menkueclab/TR-Switch/TRSW v1.2 assembled.jpg

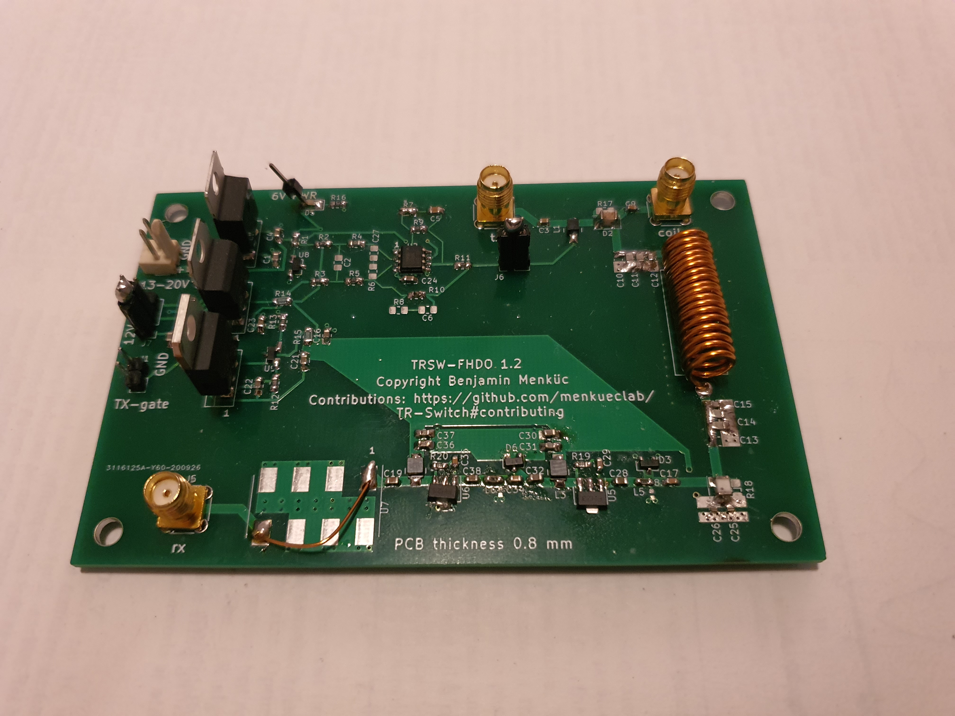
TRSW v1.2 assembled.jpg
