menkueclab/TR-Switch/measurements/orig tx to rx transition adjusted scale.jpg

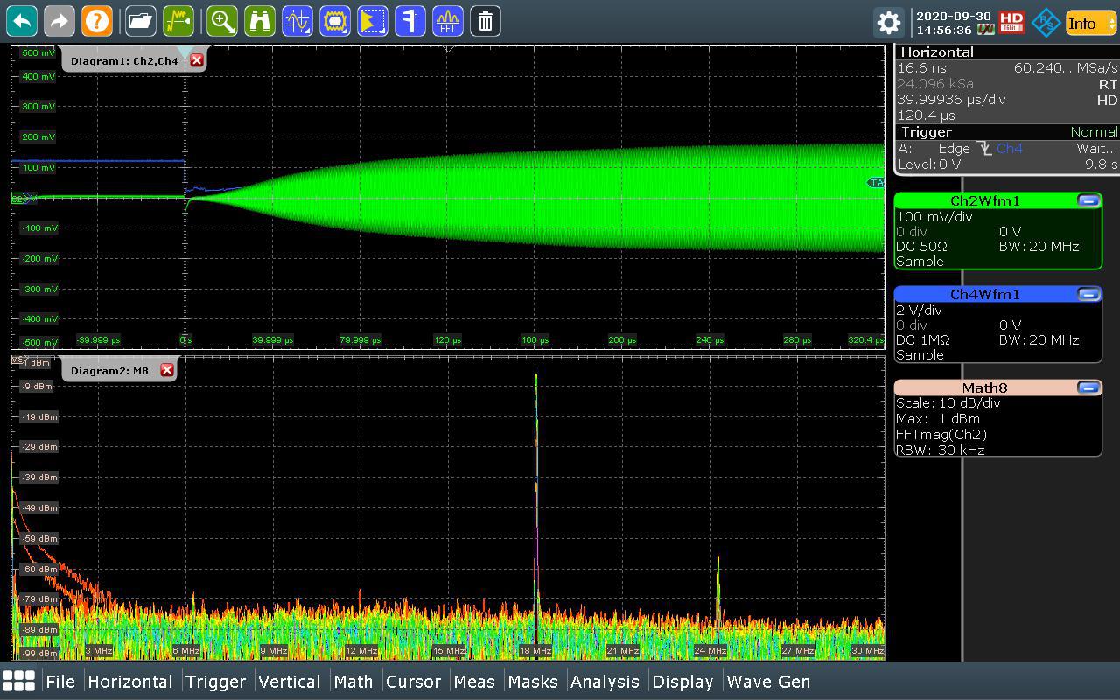
measurements/orig tx to rx transition adjusted scale.jpg
