menkueclab/TR-Switch/README.md

# TR-Switch
T/R Switch with LNA for low-field MRI.

[Read more](https://github.com/menkueclab/TR-Switch/wiki)

### Contributing

  * Jason Stockmann
  * Thomas Witzel
  * Don 
  * Lincoln Craven-Brightman
  * Marcus Prier
  * Odin Holmes

### References

  * https://tabletop.martinos.org/index.php/Hardware:RF
  * http://rflab.martinos.org/index.php/Low-noise_RF_Preamplifier
  
### Disclaimer
Not intended for medical use!
