menkueclab/TR-Switch/sim/loopgain no compensation.png

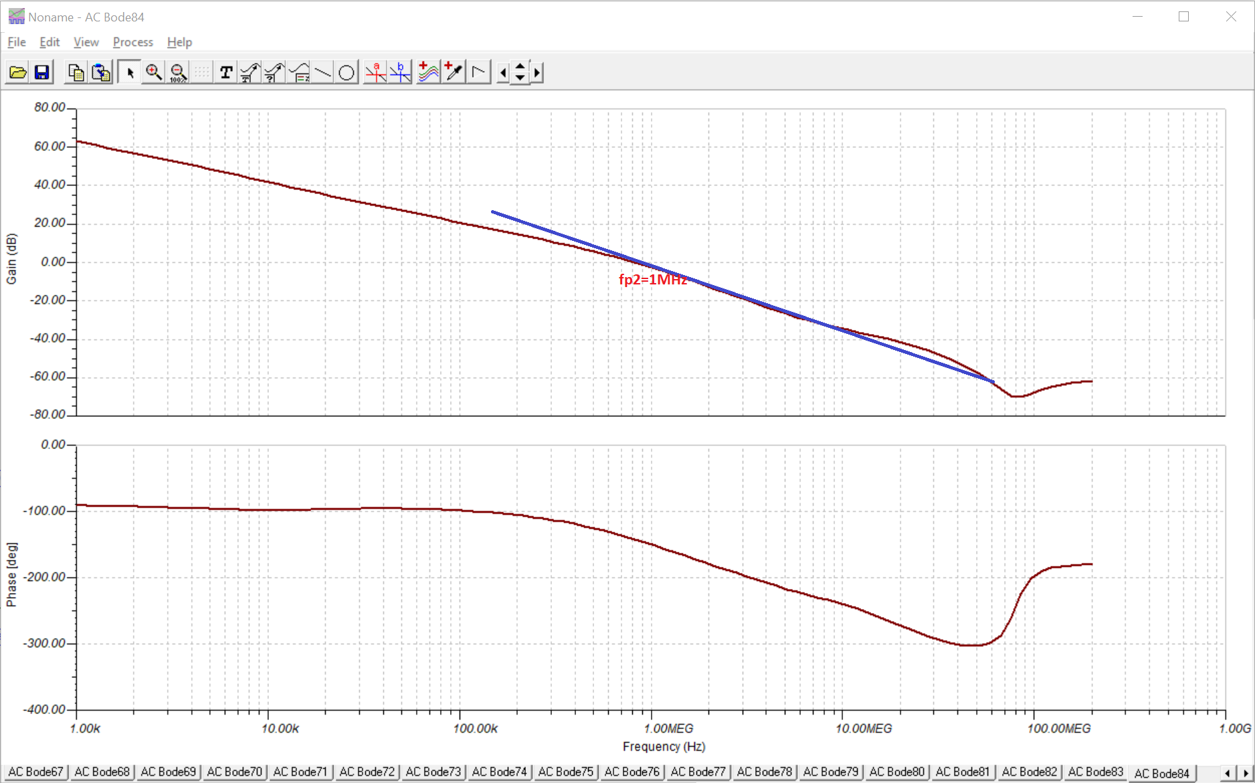
sim/loopgain no compensation.png
