menkueclab/TR-Switch/sim/loopgain with feedback lead compensation and lag compensation.png

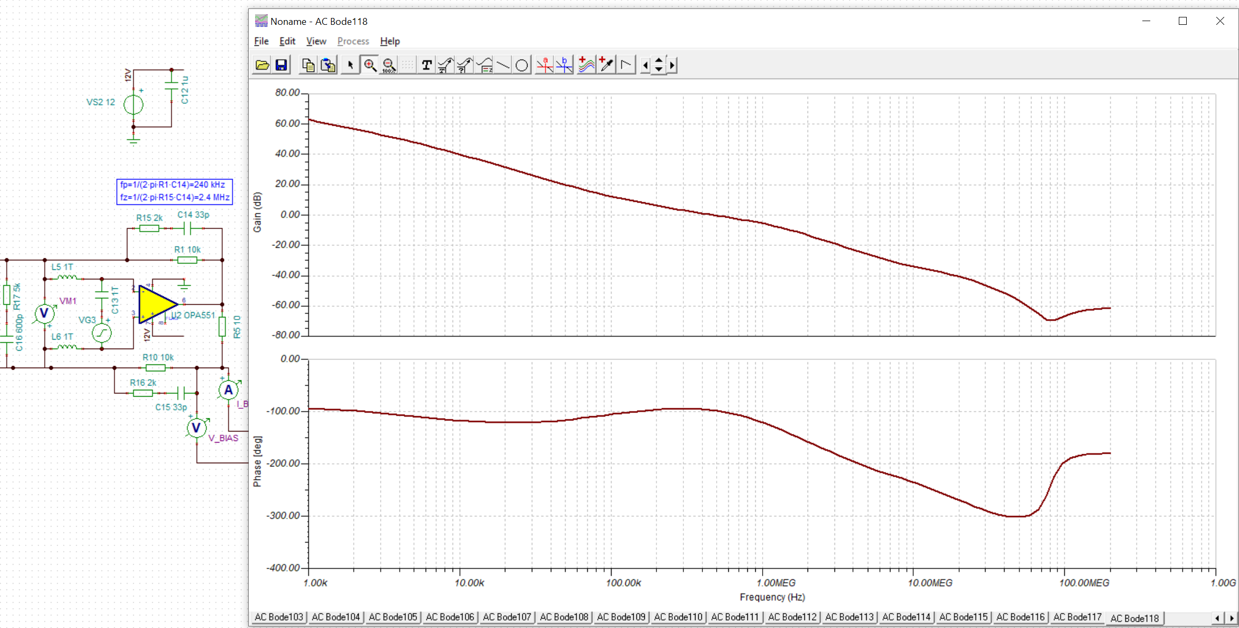
sim/loopgain with feedback lead compensation and lag compensation.png
