menkueclab/TR-Switch/sim/loopgain with feedback lead compensation.png

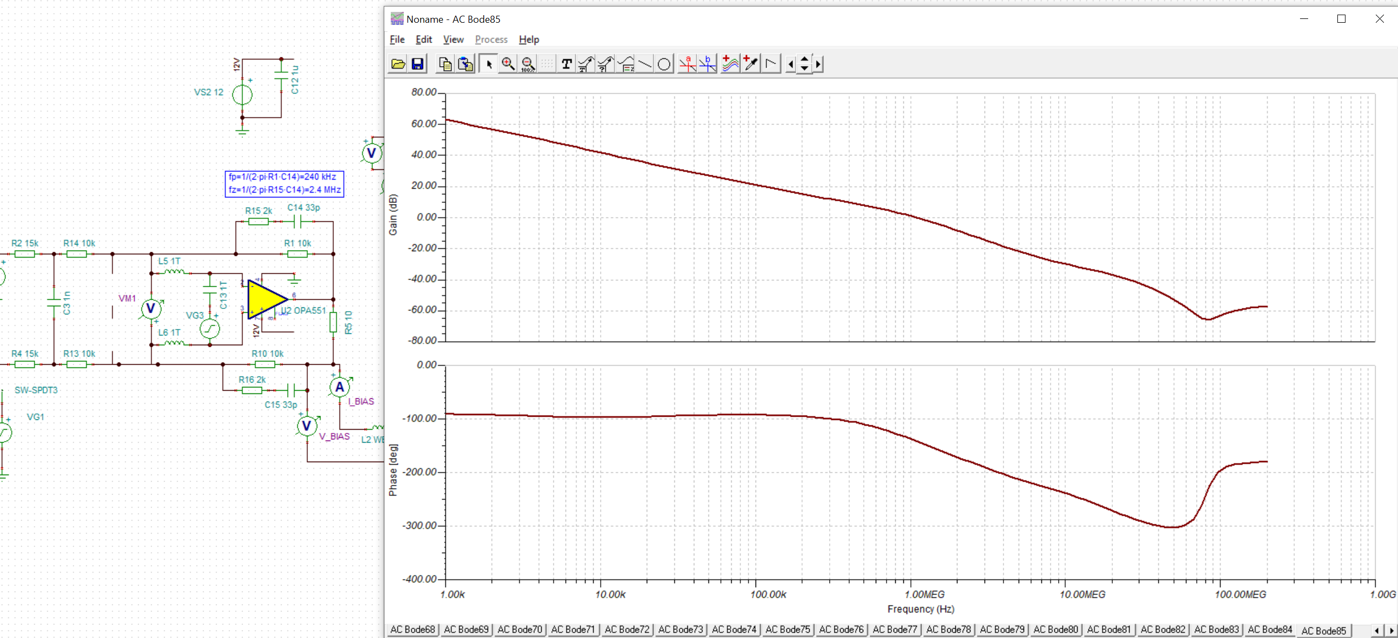
sim/loopgain with feedback lead compensation.png
