menkueclab/TR-Switch/sim/loopgain with lag compensation.png

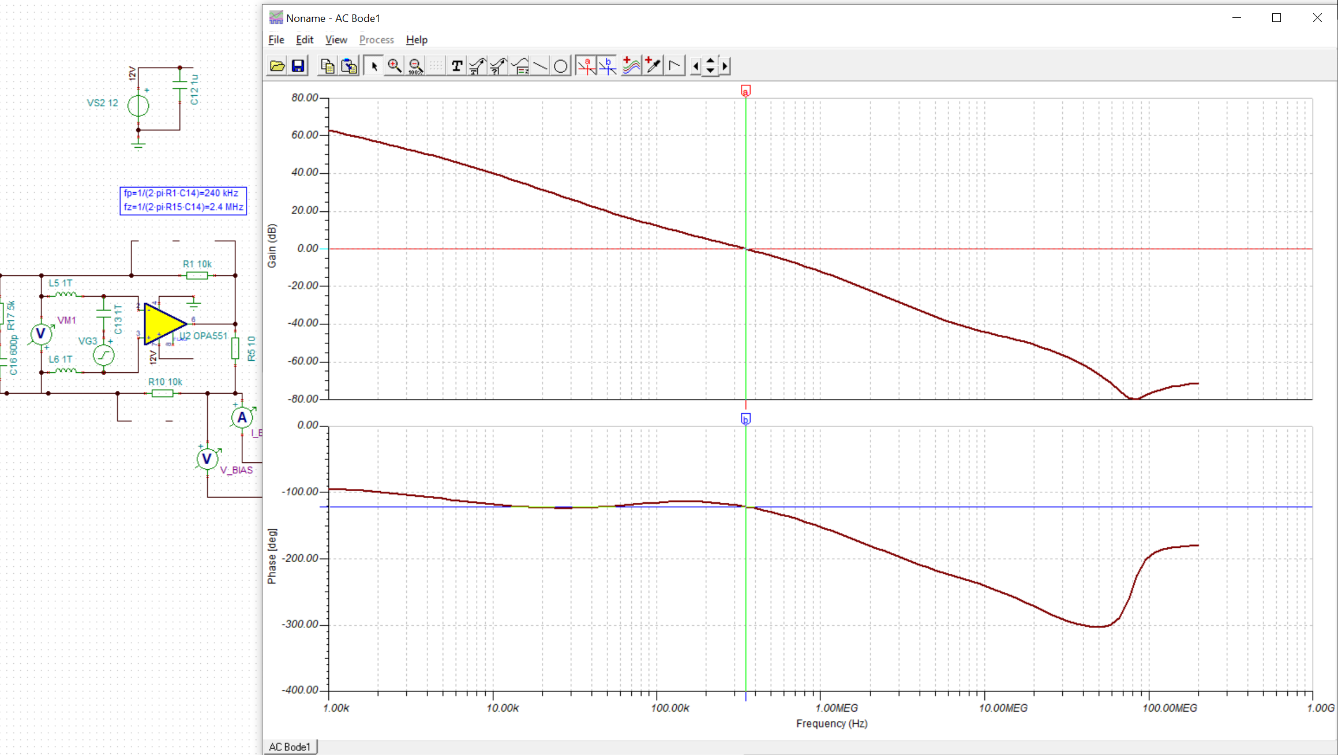
sim/loopgain with lag compensation.png
