menkueclab/TR-Switch/sim/loopgain without transmitter.png

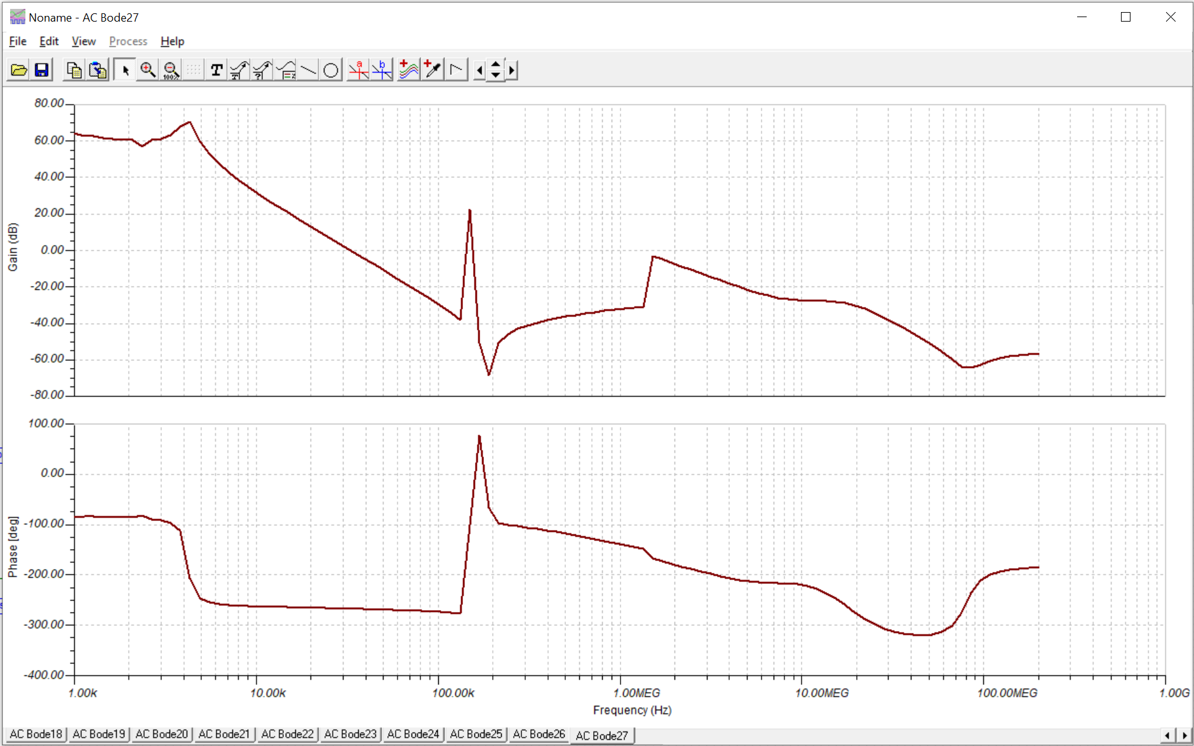
sim/loopgain without transmitter.png
