menkueclab/TR-Switch/TRSW v1.2.jpg

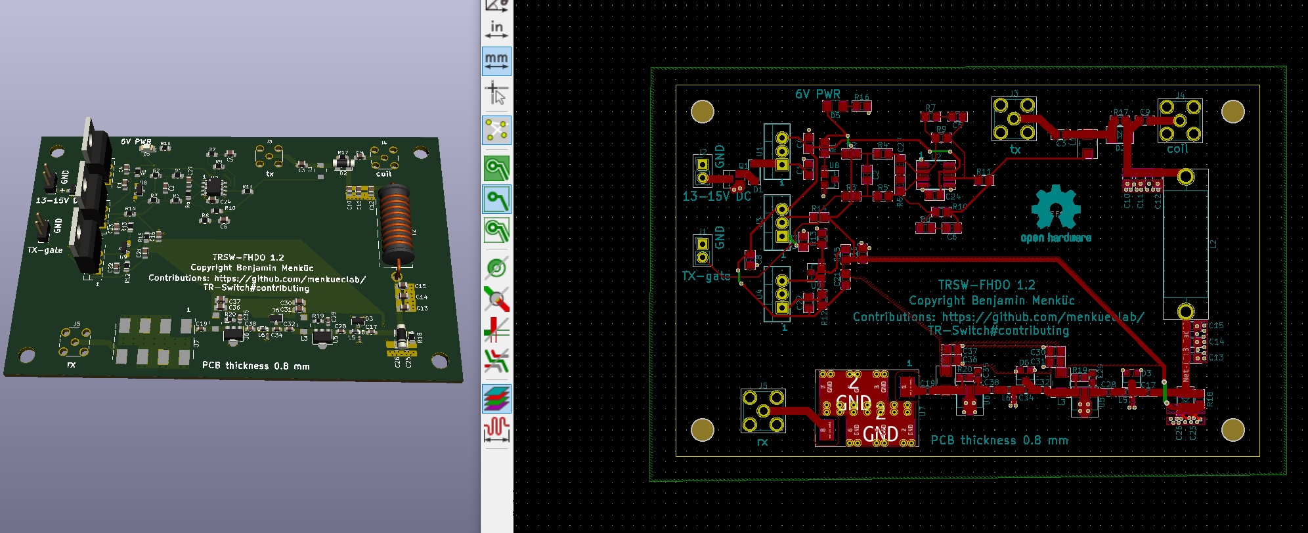
TRSW v1.2.jpg
