menkueclab/TR-Switch/parts/Warenkorb_Nov06_0358.xls

WARENKORB
Dies ist keine Rechnung
06-Nov-20 03:58:51
 | Mouser-Nr. | Herst.- Nr. | Hersteller | Kunden-Teilenr | Beschreibung | RoHS | Lebenszyklus | Stückzahl | Preis (EUR) | Gesamtpreis: (EUR)
1 | 841-BAT54GWX | BAT54GWX | Nexperia |  | Schottky Dioden & Gleichrichter DIODE SCHOTTKY | RoHS-konform |  | 1 | 0,119 € | 0,12 €
2 | 80-C0603C104J4RECLR | C0603C104J4REC7411 | KEMET |  | Kondensator aus mehreren Keramikschichten MLCC - SMD/SMT 16V 0.1uF 0603 X7R 0.05 | RoHS-konform |  | 5 | 0,161 € | 0,81 €
3 | 963-LMK107BJ225KK-T | LMK107BJ225KK-T | Taiyo Yuden |  | Kondensator aus mehreren Keramikschichten MLCC - SMD/SMT 0603 10VDC 2.2uF 10% X5R | RoHS-konform | Neues Produkt | 4 | 0,195 € | 0,78 €
4 | 605-501R15W102KV4T | 501R15W102KV4T | Johanson |  | Kondensator aus mehreren Keramikschichten MLCC - SMD/SMT 500volts 1000pF 10% X7R | RoHS-konform |  | 4 | 0,237 € | 0,95 €
5 | 963-LMK212ABJ106KGHT | LMK212ABJ106KGHT | Taiyo Yuden |  | Kondensator aus mehreren Keramikschichten MLCC - SMD/SMT 0805 10V 10uF 10% X5R AEC-Q200 | RoHS-konform |  | 6 | 0,161 € | 0,97 €
6 | 810-C0510X5R1A474MAC | C0510X5R1A474M030BC | TDK |  | Kondensator aus mehreren Keramikschichten MLCC - SMD/SMT 0204 10V 0.47uF X5R 20% T: 0.3mm | RoHS-konform |  | 2 | 0,356 € | 0,71 €
7 | 81-GRM1555C1H1R5WA1D | GRM1555C1H1R5WA01D | Murata |  | Kondensator aus mehreren Keramikschichten MLCC - SMD/SMT 1.5PF 50V .05PF 0402 | RoHS-konform | NRND | 2 | 0,102 € | 0,20 €
8 | 80-C0805X105K8RACLR | C0805X105K8RAC7210 | KEMET |  | Kondensator aus mehreren Keramikschichten MLCC - SMD/SMT 10V 1uF X7R 0805 10% Flex | RoHS-konform | Neues Produkt | 4 | 0,745 € | 2,98 €
9 | 605-501R15N470JV4T | 501R15N470JV4T | Johanson |  | Kondensator aus mehreren Keramikschichten MLCC - SMD/SMT 500volts 47pF 5% NPO | RoHS-konform |  | 4 | 0,263 € | 1,05 €
10 | 605-501R15N101JV4T | 501R15N101JV4T | Johanson |  | Kondensator aus mehreren Keramikschichten MLCC - SMD/SMT 500volts 100pF 5% NPO | RoHS-konform |  | 2 | 0,237 € | 0,47 €
11 | 80-C0603X104K5R3316 | C0603X104K5RAC3316 | KEMET |  | Kondensator aus mehreren Keramikschichten MLCC - SMD/SMT 50V .1uF X7R AUTO 5mm Flex VW80808 | RoHS-konform | Neues Produkt | 1 | 0,161 € | 0,16 €
12 | 667-ERA-3VEB1501V | ERA-3VEB1501V | Panasonic |  | Dünnfilmwiderstände - SMD 0603 0.1% 1.5Kohm 25ppm SMD | RoHS-konform | Neues Produkt | 2 | 0,449 € | 0,90 €
13 | 667-ERJ-6RED1004V | ERJ-6RED1004V | Panasonic |  | Dickfilmwiderstände - SMD 0805 Resistor 0.5% 100ppm 1MOhm |  |  | 2 | 0,178 € | 0,36 €
14 | 667-ERJ-U06F1R00V | ERJ-U06F1R00V | Panasonic |  | Dickfilmwiderstände - SMD 0805 1% 1ohm AEC-Q200 Anti-Sulfur | RoHS: Konform durch Ausnahmegenehmigung | Neues Produkt | 2 | 0,161 € | 0,32 €
15 | 652-CMP0805AFX-10R0L | CMP0805AFX-10R0ELF | Bourns |  | Dickfilmwiderstände - SMD 10 OHM 1% 1/2W TC100 | RoHS-konform | Neues Produkt | 1 | 0,102 € | 0,10 €
16 | 652-CMP0805-FX-1000L | CMP0805-FX-1000ELF | Bourns |  | Dickfilmwiderstände - SMD 100 OHM 1% 1/2W TC100 | RoHS-konform | Neues Produkt | 3 | 0,085 € | 0,26 €
17 | 652-CMP0805AFX-1002L | CMP0805AFX-1002ELF | Bourns |  | Dickfilmwiderstände - SMD 10K OHM 1% 1/2W TC100 | RoHS-konform | Neues Produkt | 4 | 0,102 € | 0,41 €
18 | 71-RCC080515K0FKEA | RCC080515K0FKEA | Vishay |  | Dickfilmwiderstände - SMD 1/4W 15Kohms 1% 100ppm | RoHS: Konform durch Ausnahmegenehmigung | Neues Produkt | 2 | 0,152 € | 0,30 €
19 | 771-PMV100EPAR | PMV100EPAR | Nexperia |  | MOSFET PMV100EPAR | RoHS-konform | Neues Produkt | 1 | 0,347 € | 0,35 €
20 | 994-0603CS-5N1XJLU | 0603CS-5N1XJLU | Coilcraft |  | Festinduktivitäten 0603 5.1nH Unshld 5% 700mA 140mOhms AECQ2 | RoHS-konform |  | 2 | 0,766 € | 1,53 €
21 | 583-BAV99 | BAV99 | Rectron |  | Dioden (Allzweck, Leistung, Schaltung) SOT23,215mA,75V,Dual,Switching | RoHS-konform |  | 2 | 0,108 € | 0,22 €
22 | 522-LM4040C25FTA | LM4040C25FTA | Diodes Incorporated |  | Spannungsreferenzen 0.5% 2.5V Reference | RoHS-konform |  | 2 | 0,542 € | 1,08 €
23 | 937-MA4P7001F-1072-T | MA4P7001F-1072T | MACOM |  | Pin-Dioden .1-1500MHz .7pF Min Vr 100Vdc |  |  | 2 | 6,01 € | 12,02 €
24 | 81-LQH32DN150K53L | LQH32DN150K53L | Murata |  | Festinduktivitäten 1210 15uH 10% 300mA 0.65ohms 26MHz(SRF) | RoHS-konform |  | 2 | 0,28 € | 0,56 €
25 | 710-744766902 | 744766902 | Wurth Elektronik |  | Festinduktivitäten WE-GFH HiFreq 4532 2.2uH 1450mA 16mOhms | RoHS-konform |  | 1 | 0,33 € | 0,33 €
26 | 424-6-PIN-HEADER | 240-004 | Digilent |  | Sockel & Kabelgehäuse 6-pin Header & Gender Changer (5-pack) | RoHS-konform |  | 4 | 1,26 € | 5,04 €
27 | 523-901-144-8RFX | 901-144-8RFX | Amphenol |  | RF-Steckverbinder/Koaxial-Steckverbinder VERTICAL PCB JACK GOLD PLATED BRASS | RoHS: Konform durch Ausnahmegenehmigung |  | 3 | 4,05 € | 12,15 €
28 | 926-LM337T/NOPB | LM337T/NOPB | Texas Instruments |  | Lineare Spannungsregler 3-TERMINAL ADJ NEG REG | RoHS: Konform durch Ausnahmegenehmigung |  | 1 | 1,47 € | 1,47 €
29 | 511-LM317T | LM317T | STMicroelectronics |  | Lineare Spannungsregler 1.2-37V Adj Positive 1.5 Amp Output | RoHS-konform |  | 1 | 0,542 € | 0,54 €
30 | 595-OPA551UA/2K5 | OPA551UA/2K5 | Texas Instruments |  | Operationsverstärker High-Volt High-Crnt Oper Amplifier | RoHS-konform |  | 1 | 3,76 € | 3,76 €
31 | 511-L7812ABV-DG | L7812ABV-DG | STMicroelectronics |  | Lineare Spannungsregler 1.5A POS REG IC 12V Output Voltage | RoHS-konform |  | 1 | 0,525 € | 0,53 €
32 | 327-BR1101WTR | BR1101W-TR | Stanley Electric |  | Standard-LEDs - SMD Surface Mount LED | RoHS-konform | Neu bei Mouser | 1 | 0,347 € | 0,35 €
33 | 994-143-11J12SL | 143-11J12SL | Coilcraft |  | Variable Induktivitäten 143 Unicoil Tunable 19.2 mOhms 6.8 A | RoHS-konform |  | 1 | 2,49 € | 2,49 €
34 | 984-ATS-PCB1001 | ATS-PCB1001 | Advanced Thermal Solutions |  | Wärmeableitungen BGA Heatsink, High Performance, Board Level Stamped, No TIM, Black-Anodized, TO-220, 19x12.8x12.7mm (LxWxH) | RoHS-konform | Neues Produkt | 3 | 0,491 € | 1,47 €
Durch das Absenden Ihrer Bestellung erklären Sie sich mit diesen Geschäftsbedingungen einverstanden. (https://eu.mouser.com/saleterms) |  |  |  |  |  |  |  |  | Gesamtwarenkosten: | 55,74 €
Die Preise sind zum angezeigten Datum und zur Uhrzeit reflektiert. |  |  |  |  |  |  |  |  | Versandkosten: | 0,00 €
 |  |  |  |  |  |  |  |  | Versand von Nachlieferungen: | Schätzung
