menkueclab/TR-Switch/measurements/orig tx to rx transition.jpg

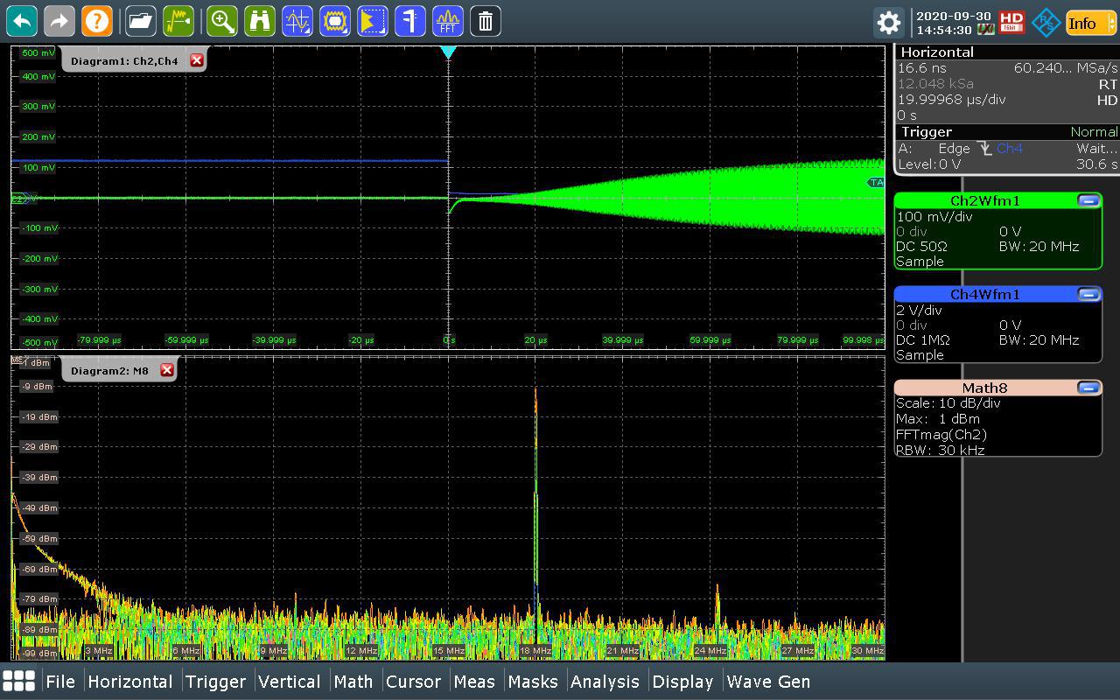
measurements/orig tx to rx transition.jpg
