menkueclab/TR-Switch/measurements/v1.1 S21 coil-rx rx-mode.png

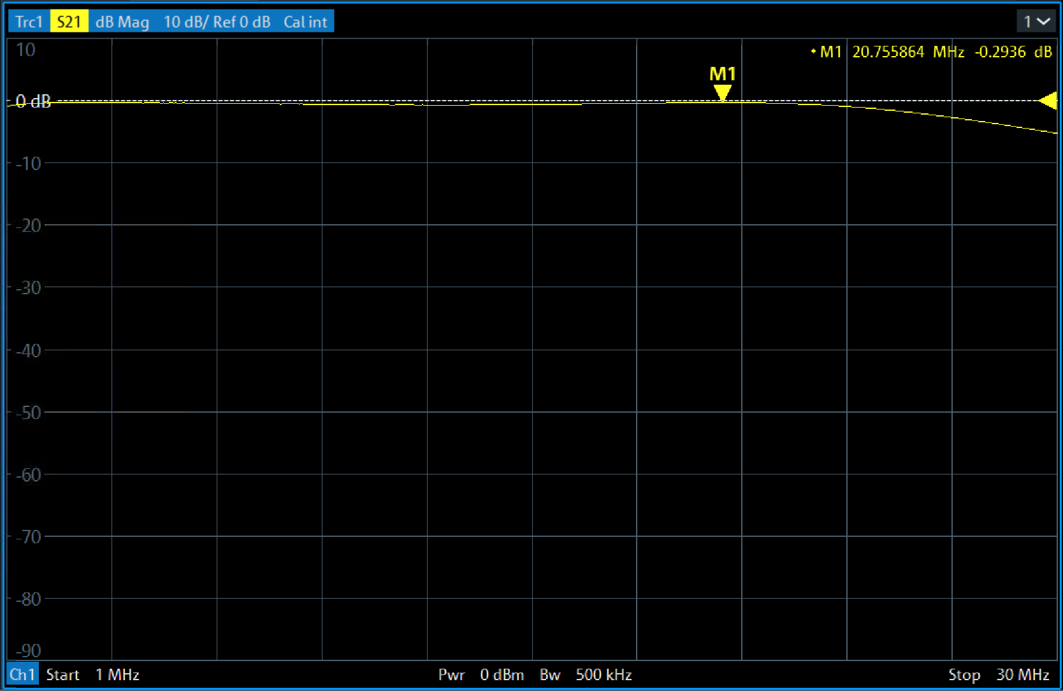
measurements/v1.1 S21 coil-rx rx-mode.png
