menkueclab/TR-Switch/measurements/v1.1 S21 tx-rx tx-mode.png

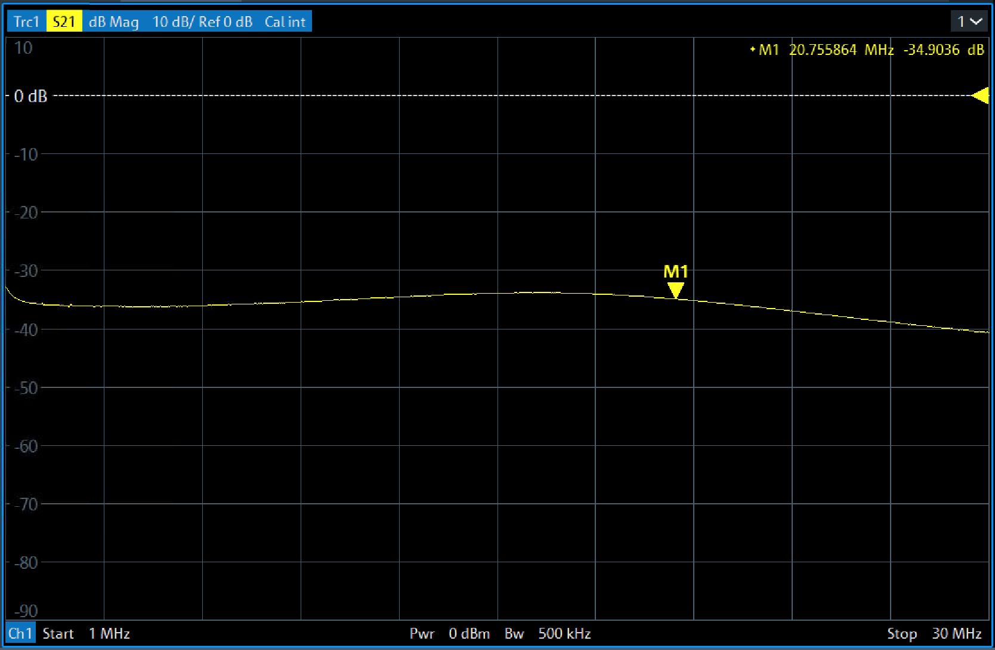
measurements/v1.1 S21 tx-rx tx-mode.png
