menkueclab/TR-Switch/measurements/v1.1 tx to rx transition.jpg

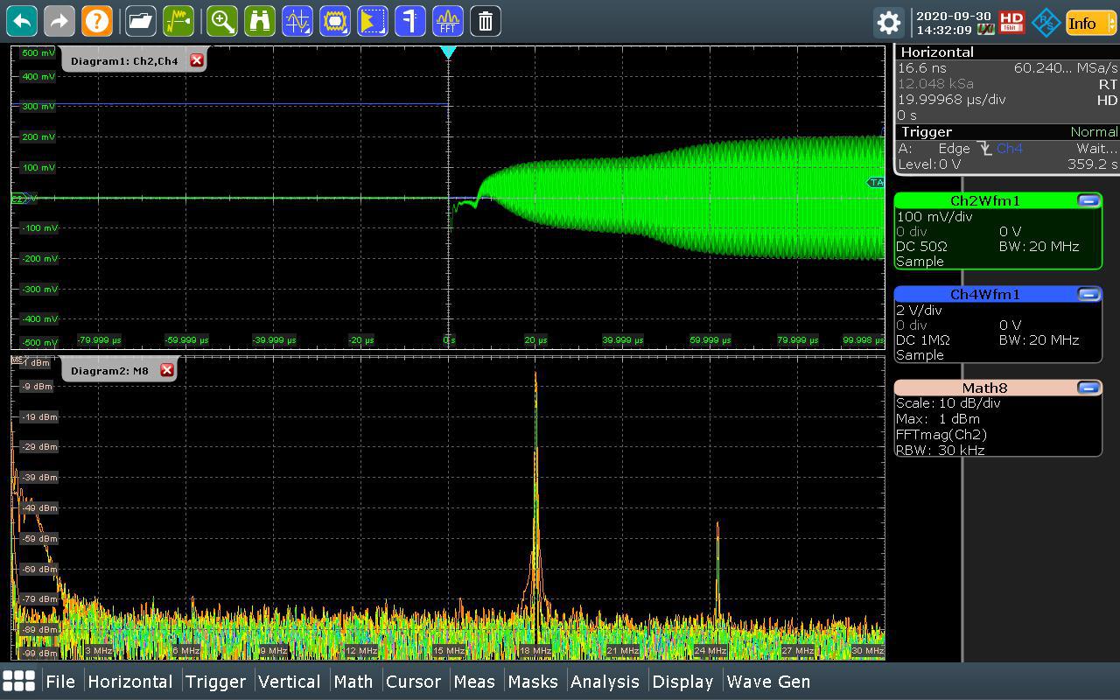
measurements/v1.1 tx to rx transition.jpg
