menkueclab/TR-Switch/measurements/v1.2 noise floor rx-mode double pha13 input open.png

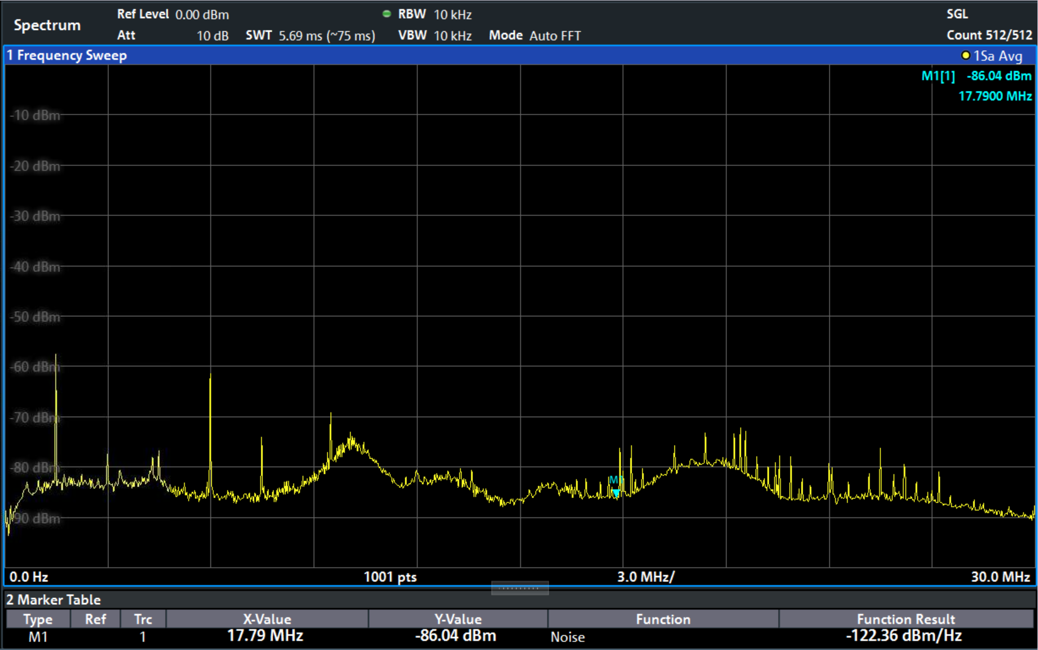
measurements/v1.2 noise floor rx-mode double pha13 input open.png
