menkueclab/TR-Switch/measurements/v1.2 S21 coil-rx rx-mode single pha13 1dB comp.png

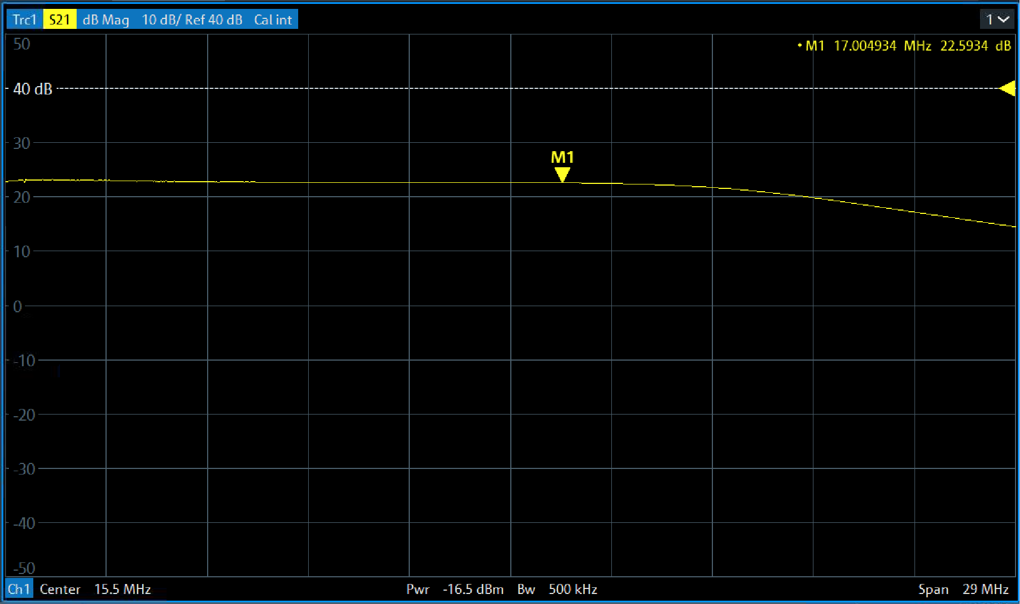
measurements/v1.2 S21 coil-rx rx-mode single pha13 1dB comp.png
