menkueclab/TR-Switch/measurements/v1.2 S21 coil-rx tx-mode single pha13.png

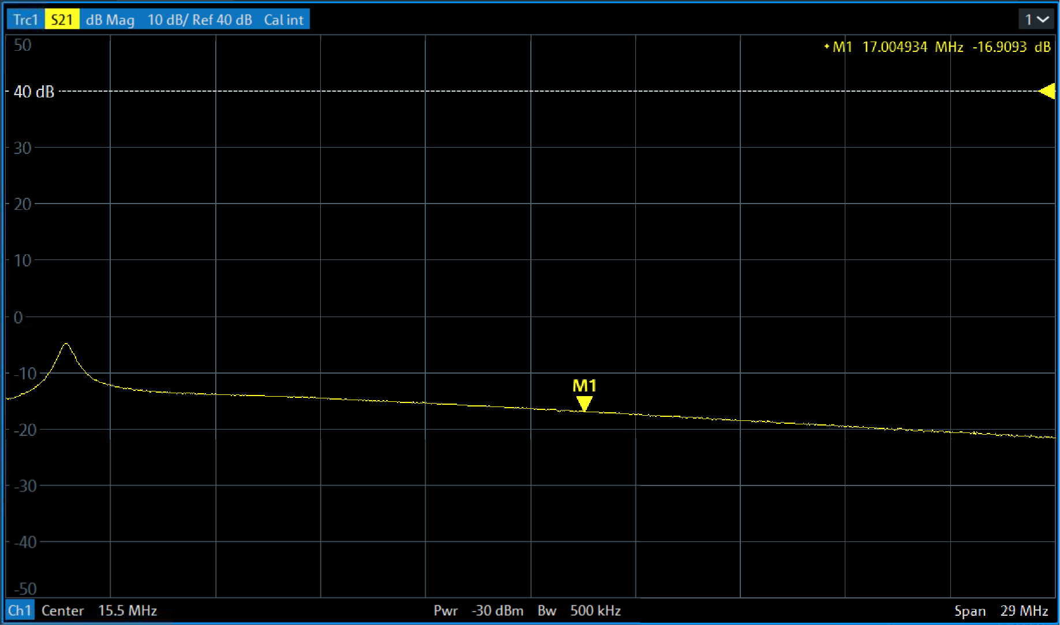
measurements/v1.2 S21 coil-rx tx-mode single pha13.png
