menkueclab/TR-Switch/measurements/v1.2 S21 tx-coil rx-mode.png

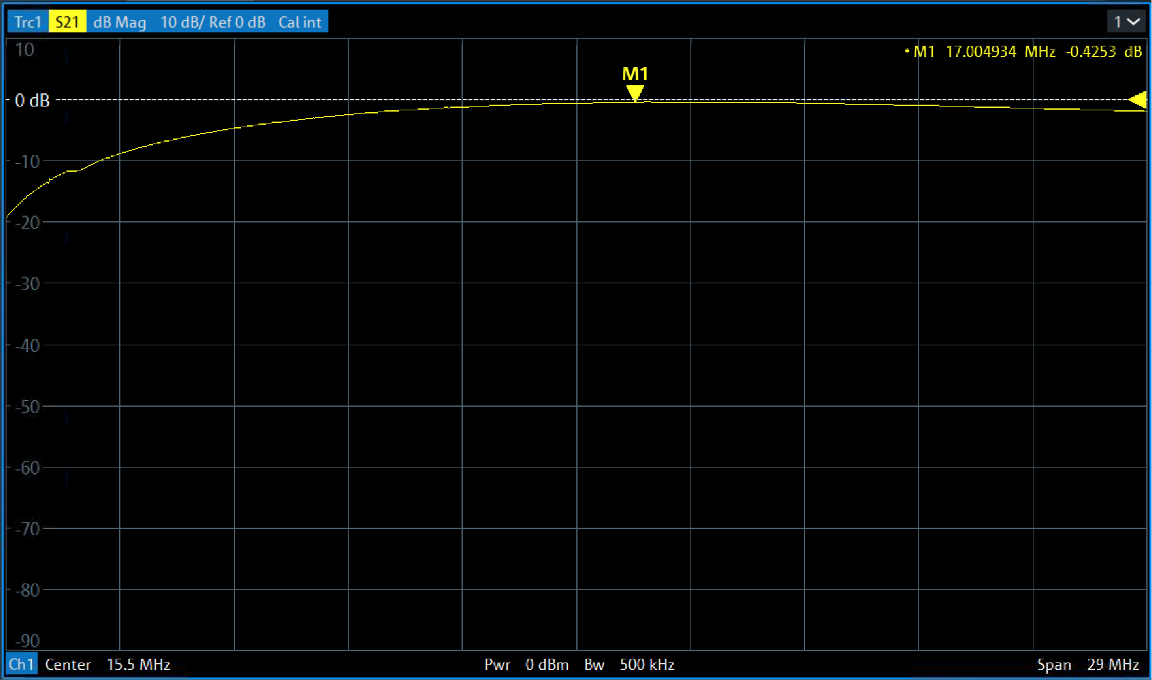
measurements/v1.2 S21 tx-coil rx-mode.png
