menkueclab/TR-Switch/measurements/v1.2 S21 tx-rx tx-mode.png

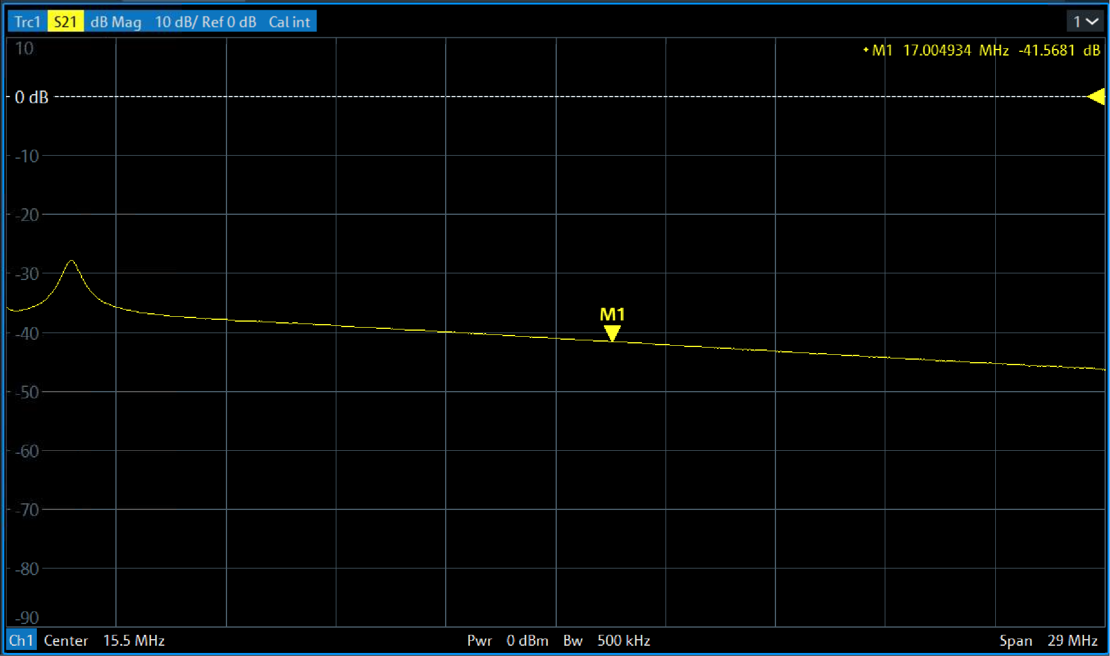
measurements/v1.2 S21 tx-rx tx-mode.png
