menkueclab/TR-Switch/measurements/ZNL noise floor input open.png

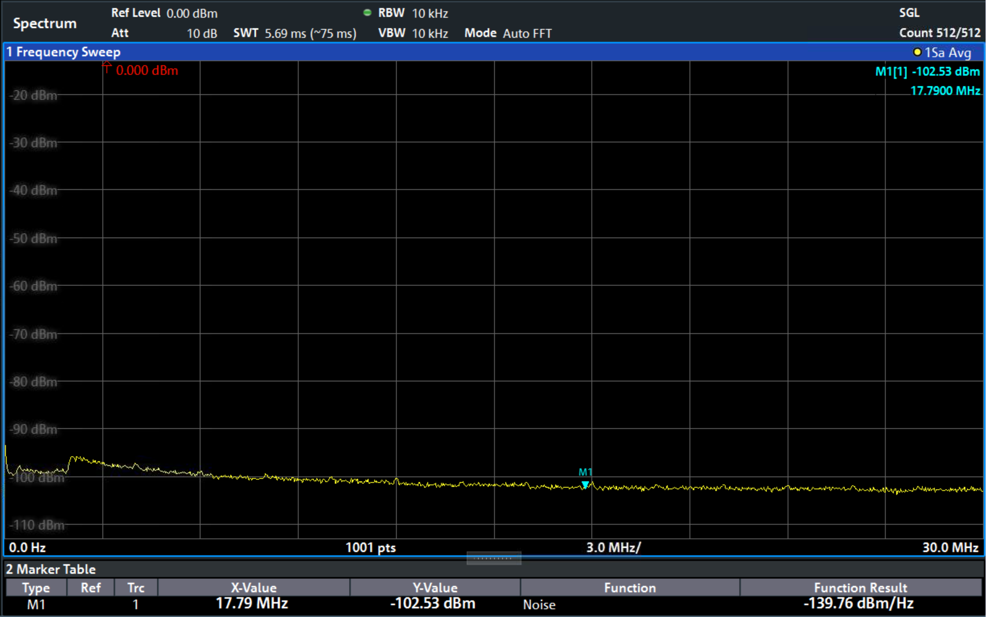
measurements/ZNL noise floor input open.png
