menkueclab/TR-Switch/(commit log)

2020-07-12 started schematic
    [TR-Switch v1.kicad_pcb, TR-Switch v1.sch]
2020-07-12 - schematic almost finished - added SPICE (TINA-TI) simulation
    [TR-Switch v1.sch]
2020-07-16 finished v1.0 pcb
    [TR-Switch v1.kicad_pcb, TR-Switch v1.sch]
2020-07-16 - Fehler behoben - Kondensatoren hinzugefügt
    [TR-Switch v1.kicad_pcb, TR-Switch v1.sch]
2020-07-17 updated component values and simulation rise / falltime is about 3 us
    [TR-Switch v1.sch]
2020-07-29 updated component value
    [TR-Switch v1.sch]
2020-08-01 removed version from filename (use git tag instead)
    [TR-Switch.kicad_pcb, TR-Switch.sch]
2020-08-01 - changed 2.5v ref to more precise one - added decoupling cap for opamp
    [TR-Switch.kicad_pcb, TR-Switch.sch]
2020-08-01 added alternative SMT 90 ohms bias resistor, because smd resistors become very hot
    [TR-Switch.kicad_pcb, TR-Switch.sch]
2020-08-02 added extra vias to decrease ESL and extra decoupling caps at critical locations
    [TR-Switch.kicad_pcb, TR-Switch.sch]
2020-08-02 added extra solder mask to some areas
    [TR-Switch.kicad_pcb]
2020-08-03 changed some capacitors to low ESL types
    [TR-Switch.kicad_pcb, TR-Switch.sch]
2020-08-04 added lead lag compensation
    [TR-Switch.kicad_pcb, TR-Switch.sch]
2020-08-04 increased diode pads to make it fit for more types
    [TR-Switch.kicad_pcb]
2020-08-11 made component values match simulation
    [TR-Switch.sch]
2020-09-18 updated component values
    [TR-Switch.sch]
2020-09-18 changed gali74 to pha13 and various other improvements
    [TR-Switch.sch]
2020-09-18 assigned footprints
    [TR-Switch.sch]
2020-09-19 added heatsinks
    [TR-Switch.sch]
2020-09-21 finished layout for version 1.2
    [TR-Switch.kicad_pcb, TR-Switch.sch]
2020-09-21 cosmetic improvements
    [TR-Switch.kicad_pcb, TR-Switch.sch]
2020-09-23 made bias voltage selectable from 12V or input voltage
    [TR-Switch.kicad_pcb, TR-Switch.sch]
2020-11-19 added parts folder with eddited BOM file and example mouser cart
    [TR-Switch.csv, Warenkorb_Nov06_0358.xls]
2024-01-24 convert to Kicad 7 format
    [TR-Switch.csv, TR-Switch.kicad_pcb, TR-Switch.sch]
