menkueclab/TR-Switch/(notices)

Notices in the files:
PCB/TR-Switch/TR-Switch.kicad_pcb:
Copyright Benjamin Menküc
